KaptainKris92/vape-logger/docs/images/1-PXL_20261016_123328457.jpg

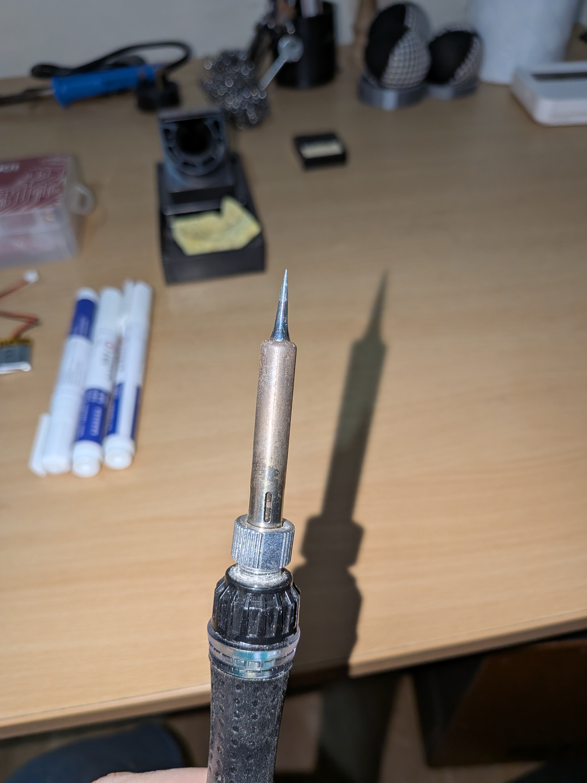
docs/images/1-PXL_20261016_123328457.jpg
