KaptainKris92/vape-logger/case/vape-logger-case-lid.stl

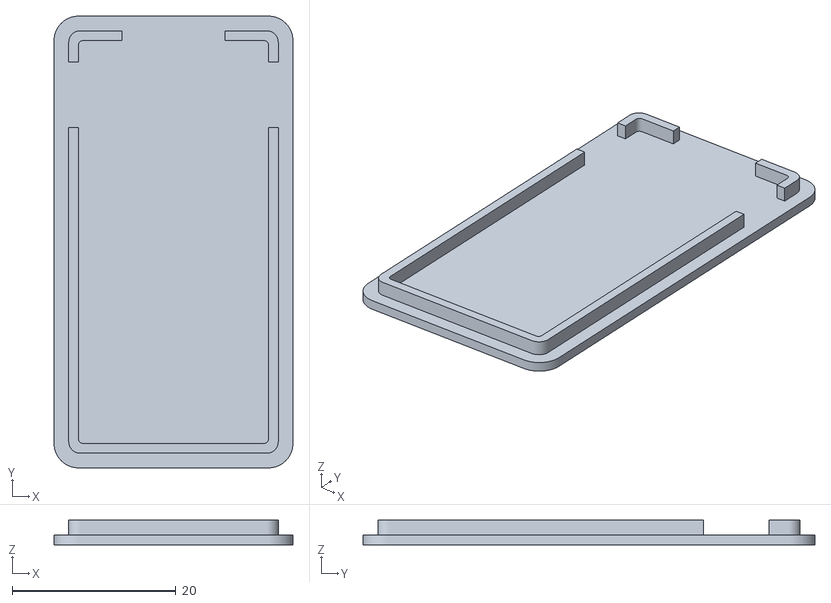
[picture p2: CAD file, 2026-10-16]
case/vape-logger-case-lid.stl
29.2 x 55.2 x 3.00
