KaptainKris92/vape-logger/case/vape-logger-case-tray.stl

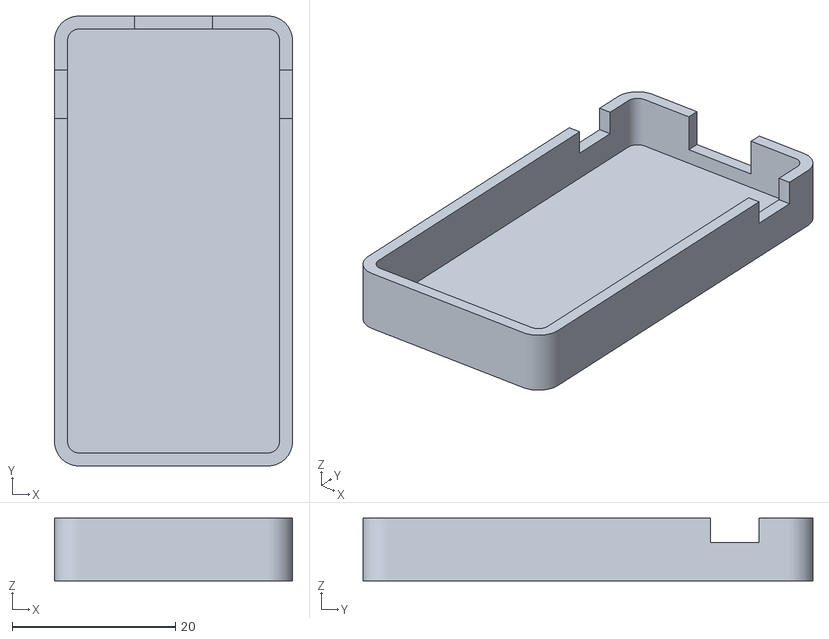
[picture p3: CAD file, 2026-10-16]
case/vape-logger-case-tray.stl
29.2 x 55.2 x 7.70
