KaptainKris92/vape-logger/(commit log)

2026-10-15 Add README and build journal
    Project background, goals, chosen approach, parts list with links,
    wiring, software plan, milestones, safety notes and first journal entry.
    Claude-Session: https://claude.ai/code/session_01B3RkUxRSWnZafjyEbQbuUk
2026-10-16 Add 3D-printable case (tray and press-fit lid) with its generator script
    Claude-Session: https://claude.ai/code/session_01MA5wcMsSGhBs4DBqA8ASqK
    [vape-logger-case-lid.stl, vape-logger-case-tray.stl]
2026-10-16 Add a no-wiring Bluetooth test sketch
    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
2026-10-16 Add How It Works explainer and soldering guide; log the Bluetooth test
    Also corrects the journal's pull-down advice: a larger resistor, not a
    smaller one, makes the FSR more sensitive.
    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
2026-10-17 Add case, parts-in-case and on-the-vape tabs to the 3D model
    The case tabs embed the real STL files from case/, so the model matches
    what gets printed.
    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
2026-10-17 Add 0.2mm 20% infill w adhesion, no supports, gcode
2026-10-18 Include Adafruit_TinyUSB.h in fsr_test so Serial links
    The Seeed nRF52 core provides Serial through the TinyUSB library, and the
    IDE does not always pull it in for a sketch that includes nothing else,
    which fails with "undefined reference to `Serial'".
    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
    [fsr_test.ino]
2026-10-18 Journal: soldering done, working on battery
    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
2026-10-19 Add Ultimaker gcode file for 3D printed case
2026-10-19 Add main firmware and the Vaper Taper app
    Firmware (firmware/vaper_taper): logs FSR presses with time and duration
    to InternalFS, keeps the last 2048, and serves them over a custom BLE
    service plus the Battery Service. Sleeps in System ON so the clock keeps
    running, and accepts a PC and a phone at once.
    App (app/): one installable Web Bluetooth app for Chrome/Edge on Windows
    and Chrome on Android. Awake-time streaks with nights excluded, night
    puffs counted separately with per-night bedtimes, record, achievements,
    a levelling buddy with a coin shop, battery level, and backups.
    Published to GitHub Pages by a workflow.
2026-10-19 App: wait for the device's advert before reconnecting after a refresh
2026-10-19 Add a Windows tray app that wraps the web app in Electron
    desktop/ loads app/ over a private scheme, picks the Vaper Taper in
    select-bluetooth-device so there is no picker, retries every 30 s,
    hides to the tray on close and starts with Windows. The page gets a
    CSP and a vaperTaperAutoConnect() hook for the wrapper.
2026-10-19 Fix the desktop app getting stuck on "Connecting..."
    A reconnect could hang for ever, or keep failing because Windows
    returned the device's services without the Vaper Taper one. Each
    attempt now times out after 30 s, and the Windows app starts again
    from a fresh device lookup after three failures. Notification
    listeners are added once, so reconnects don't duplicate them.
2026-10-20 Add a step-by-step build blog with web-sized photos
    The blog in blog/index.md tells the whole build from ordering to the app,
    for someone new to hardware. The photos are resized copies with no
    metadata. The case README now records the print settings actually used.
    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
2026-10-25 Bring the README and docs up to date; move the blog to the website
    The build blog now lives on kaptainkris92.github.io, so blog/ and the
    full-size photos/ are removed. Status, milestones and the sleep notes
    now match the device as built.
    Claude-Session: https://claude.ai/code/session_01Fx3cgjLLbQ7kgkhLGZoJvF
